Electrodudegit/AURA/firmware/README.md

# Firmware: AURA v3.1.6

[`AURA_v3/`](AURA_v3/) is the full Arduino sketch folder. Open **`AURA_v3/AURA_v3.ino`** in Arduino IDE 2.x and keep every file in the same folder.
You can also download the same sketch as a zip from [`releases/AURA_v3_subscriber.zip`](../releases/AURA_v3_subscriber.zip).

- **Board:** ESP32 Dev Module · **Partition:** Huge APP (3MB No OTA / 1MB SPIFFS). The first v3.1.6 upload must be a full Arduino upload so the partition table is written.
- **Core:** esp32 by Espressif Systems 3.3.x · **Library:** NimBLE-Arduino by h2zero 2.5.x
- `secrets.h` / `secrets.example.h` only hold the placeholder `put your credential here`. After flashing, enter your Wi-Fi and API keys on the device under **Settings → Credentials**. They are saved in NVS.
- `extras/companion/` is the v3.1.6 laptop helper (`aura_companion.py` and `run_companion.bat`). It talks to one AURA on the same Wi-Fi (CPU, RAM, notifications, Now Playing). Nothing is uploaded to the cloud. `extras/host/` is a host test bench. Neither is required to flash the board.

See the main [README](../README.md#-flashing-the-firmware) for the full steps.
