Electrodudegit/AURA/firmware/AURA_v3/docs/README.md

# ELECTRO DUDE docs

Official notes for AURA.

- Start with the repository README: download the zip, flash with the Arduino IDE, then type Wi-Fi on the device.
- [PROFILE.md](PROFILE.md) is a short bio and logo for an Origin or GitHub profile.
- Logo: [brand/electro-dude-logo.png](brand/electro-dude-logo.png)

## Social

- YouTube: https://www.youtube.com/c/ElectroDude
- Instagram: https://www.instagram.com/electro__dude/
- Hackster: https://www.hackster.io/Electrodude/
- Facebook: https://www.facebook.com/Electroodude

Do not paste Wi-Fi names, passwords, or API keys into anything committed here.
