Electrodudegit/AURA/hardware/step/AURA_enclosure.step

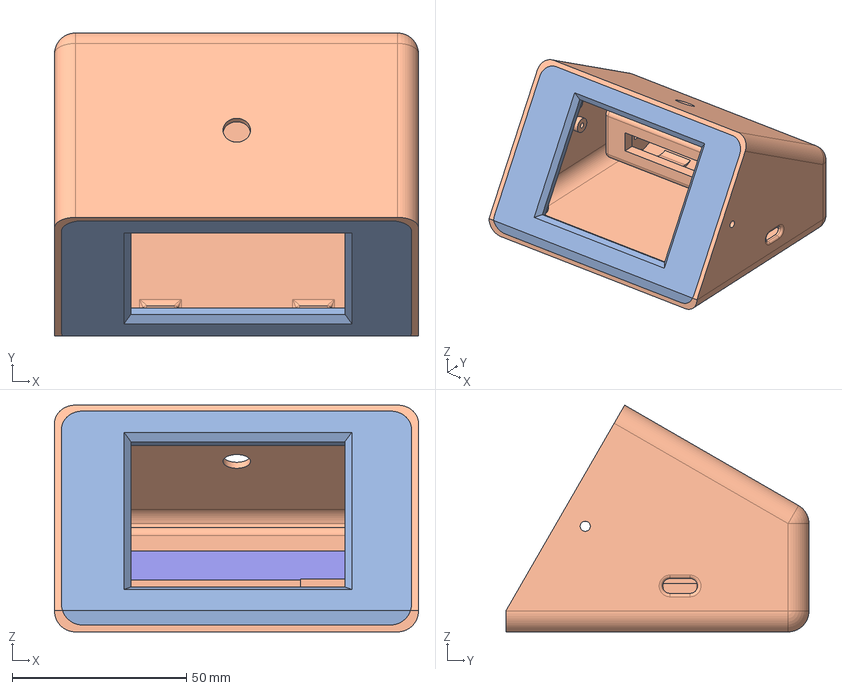
[picture p4: CAD file, 2026-10-31]
hardware/step/AURA_enclosure.step
104.5 x 87.0 x 65.1 mm
